Eelis/freeskate-holder/(threads)

Thread 1 (2022-09-16):

Build script hangs

SaberMage, 2022-09-16:
Seems like the build script just gets stuck at
```Creating frame.stl...```
and won't proceed. Any idea what the issue might be?

Running the script on Ubuntu.

SaberMage, 2022-09-16:
Update: Apparently it takes a whole 15 minutes or more to process. Here's the current STL set as of this comment date.

[stl.zip](https://github.com/Eelis/freeskate-holder/files/9581812/stl.zip)

Eelis, 2022-09-16:
Thanks for the report, it's definitely not supposed to take that long. I'll do some debugging later.

Thread 2 (2023-07-07):

Trying to contact about Grapple Map

lundegard1, 2023-07-07:
Hi, sorry for the misplaced issue, but I'm trying to reach out to Eelis about the Grapple Map. I would like to use the Grapple Map in Blender to create synthetic data for a machine learning algorithm for my Master's thesis. If you could reach out to me at lundegard1@gmail.com I would greatly appreciate it. It looks like you put a lot of work into it and I would love to build on it.

I tried the blender script, but the repo is missing the "dump" file. I've since been trying to build the C++ code on a Windows computer so I can decode the database and I'm struggling to do so.

Thanks for any help you're willing to provide.

Eelis, 2023-07-07:
Hi Garrett,

Thanks for contacting me. I tried to reply to your email, but got some error from gmail saying they don't allow their users to receive mail from people like me who don't use SPF or DKIM, so they didn't allow me to reply to you. I've never gotten such an error before. (If I were you, I'd choose an email provider that doesn't interfere with my communications.)

Anyway, it's been a while, but I believe a dump file can be generated using the --dump option of the grapplemap-glfw-playback program.

I've attached an old dump file I found, no idea if it still works. (Github made me add the `.txt` extension, otherwise it wouldn't allow me to attach it.) [dump.txt](https://github.com/Eelis/freeskate-holder/files/11981015/dump.txt)

(In general, I haven't touched the GrappleMap in ages, so it's probably completely bit-rotted and would require considerable work to revive. Maybe I'll get to it one day.)

Cheers,

Eelis

lundegard1, 2023-07-07:
Oh, that's odd. Thanks for the file though! I will try it out. And if you want to reach me, here's another email you can try: garrett.lundegard@haw-hamburg.de

I hope you return to that project one day. I think there's a lot of potential there, and it's fascinating even in its current state.

Cheers!
Garrett
