Eelis/freeskate-holder/(commit log)

2020-04-04 Initial version.
    [design.scad]
2020-04-04 Clean up lower platform attachment and reorder modules a bit.
    [design.scad]
2020-04-07 Make cutouts for bolt head and nut.
    [design.scad]
2020-04-09 Fix skate measurements and gaps around skates.
    [design.scad]
2020-04-09 Increase tolerance between sliding parts.
    The print worked with 0.5 but the parts were rubbing eachother too much.
    [design.scad]
2020-04-09 Fix some overlap and add support for upper platform.
    [design.scad]
2020-04-09 Make clip stronger and close better.
    [design.scad]
2020-04-09 Distinguish left and right skate.
    [design.scad]
2020-04-09 Make lower platform less bloated.
    [design.scad]
2020-04-09 Make wheels not black so they are lit.
    [design.scad]
2020-04-09 Make skates move further out in animation.
    [design.scad]
2020-04-09 Fix some epsilons.
    [design.scad]
2020-04-09 Color device gold.
    [design.scad]
2020-04-09 Split sources into multiple scad files.
    [animation.scad, clip.scad, constants.scad, design.scad, frame.scad, skate.scad, util.scad]
2020-04-09 Add .stl files to repo.
    [clip.stl, frame.stl]
2020-04-09 Move SCAD and STL files into subdirs.
    [animation.scad, clip.scad, clip.stl, constants.scad, frame.scad, frame.stl, skate.scad, util.scad]
2020-04-09 Link to STL files in readme.
2020-04-09 Move clip printing hint to better location in README.
2020-04-09 Make source layout more consistent.
    [animation.scad, clip.scad, frame.scad, skate.scad, util.scad]
2020-04-10 Add pictures of non-printed parts.
2020-04-10 Lower roof and raise walls around upper platform.
    [frame.scad]
2020-04-10 Tweak corner radius to more closely trace deck.
    [constants.scad]
2020-04-10 Lower upper skate onto upper deck.
    [animation.scad]
2020-04-10 Redesign bridge.
    [frame.scad]
2020-04-10 Use wide corner for lower backstop as well.
    [animation.scad, constants.scad, frame.scad]
2020-04-10 Fix skate and show bracket.
    [skate.scad, util.scad]
2020-04-10 Make skate more realistic.
    [constants.scad, skate.scad, truck.scad]
2020-04-11 Raise lower structures up to upper platform.
    [frame.scad]
2020-04-14 Clean up some whitespace.
    [frame.scad, skate.scad, truck.scad]
2020-04-17 Update printing price indication.
2020-04-17 Improve clip strength and ergonomics.
    [clip.scad, constants.scad, frame.scad, skate.scad]
2020-04-17 Orient animation the right way up.
    [animation.scad]
2020-04-21 Use $fa = 1.
    [constants.scad]
2020-04-22 Fix hex nut cutout.
    [frame.scad]
2020-04-22 Tweak skate length measurement.
    [constants.scad]
2020-04-22 Make upper platform slightly shorter.
    [animation.scad, frame.scad]
2020-04-22 Reduce bridge width.
    [frame.scad]
2020-04-22 Make lower platform slightly shorter.
    [constants.scad, frame.scad]
2020-04-22 Reduce gap around skates.
    [constants.scad, frame.scad]
2020-04-22 Make cliphouse back wall edge less sharp.
    [frame.scad]
2020-04-22 Expand upper platform support.
    [frame.scad]
2020-04-22 Raise side walls.
    [frame.scad]
2020-04-22 Strengthen lower platform.
    [frame.scad]
2020-04-22 Close holes in bridge roof.
    [frame.scad]
2020-04-22 Clean up lower edge of bridge.
    [frame.scad]
2020-04-22 Make clip stronger.
    [clip.scad, frame.scad]
2020-04-22 Connect underside of cliphouse.
    [frame.scad]
2020-04-22 Avoid collisions in animation.
    [animation.scad]
2020-04-23 Add bolt in animation.
    [animation.scad]
2020-05-07 Refactor some parts using extrusions.
    [clip.scad, frame.scad, skate.scad, util.scad]
2020-05-07 Add cord attachment points at midpoint.
    [frame.scad]
2020-05-15 Lots of changes: - tilt walls to form well shape - make edges of wall round - tilt cliphouse for tilted skate - make hooks bigger and round - add skirt - refactor animation code
    [animation.scad, clip.scad, constants.scad, frame.scad, single.scad, single_anim.scad, skate.scad, util.scad]
2020-05-16 Don't use hull().
    [clip.scad]
2020-05-16 Refactor clip into mirrored halves.
    [clip.scad, single.scad]
2020-05-16 Update animation.
    [animation.scad]
2020-05-16 Remove some unused functions.
    [single.scad, skate.scad, util.scad]
